MoneShadow/stm32-industrial-protocol-gateway/f103_node/Core/Src/main.c

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
/* Includes ------------------------------------------------------------------*/
#include "main.h"
#include "can.h"
#include "usart.h"
#include "gpio.h"

/* USER CODE BEGIN Includes */

#include "can.h"

/* USER CODE END Includes */


/* USER CODE BEGIN PV */

volatile uint8_t heartbeat_in_flight = 0;
volatile uint8_t stateframe_in_flight = 0;
state volatile state_frame = {0};

/* USER CODE END PV */

void SystemClock_Config(void);
/* USER CODE BEGIN 0 */

volatile static uint16_t least_rpm = 0;
uint8_t Set_RPM(uint16_t rpm) {
  if (rpm == least_rpm) {
    return 2; // 目标转速重复，可以认为设置成功
  }
  if (0) {
    return 0; // 设置失败
  }
  least_rpm = rpm;
  HAL_GPIO_TogglePin(LED_TEST_GPIO_Port, LED_TEST_Pin);
  return 1; // 设置成功
}

uint8_t state_num = 0;
uint8_t Get_State(void) {
  if (0) {
    return 1; // 获取状态失败 以后再实现
  }
  state_frame.curentrpm = 930;
  state_frame.targetrpm = least_rpm;
  state_frame.voltage = 240;
  state_frame.temperature = 36;
  state_frame.state = 0x01;
  state_frame.errorcode = 0x00;
  state_frame.statenum = state_num++;
  return 0; // 获取状态成功
}

/* USER CODE END 0 */

/**
  * @brief  The application entry point.
  * @retval int
  */
int main(void)
{

  /* MCU Configuration--------------------------------------------------------*/

  /* Reset of all peripherals, Initializes the Flash interface and the Systick. */
  HAL_Init();

  /* Configure the system clock */
  SystemClock_Config();

  /* Initialize all configured peripherals */
  MX_GPIO_Init();
  MX_CAN_Init();
  MX_USART1_UART_Init();
  /* Infinite loop */
  /* USER CODE BEGIN WHILE */

  volatile static uint32_t least_tick_heart = 0;
  volatile static uint32_t least_tick_command = 0;
  volatile static uint32_t least_tick_state = 0;
  volatile static uint32_t heart_num = 0;
  least_tick_heart =  HAL_GetTick();
  least_tick_command =  HAL_GetTick();
  least_tick_state =  HAL_GetTick();
  while (1)
  {
    if (((HAL_GetTick() - least_tick_heart) >= 500) && !heartbeat_in_flight) {
      least_tick_heart = HAL_GetTick();
      CAN_Heart(heart_num++);
    }

    /* 执行控制命令 */
    if (((HAL_GetTick() - least_tick_command) >= 10) && Event_Flats.Total_Event > 0) {
      least_tick_command = HAL_GetTick();
      uint8_t commandcode = 0, commanddata[8], commandnum = 0;
      if (Event_Flats.RPM_Event > 0) {
        Event_Flats.Total_Event--;
        Event_Flats.RPM_Event--;
        if (ReadCommandValue(0x01, commanddata)) {
          /* 命令空  */
          Event_Flats.Error_Event++;
        }
        else {
          uint16_t rpm = 0;
          uint8_t status = 0;
          commandcode = commanddata[0];
          rpm = commanddata[1] | commanddata[2] << 8; // 小端序保存
          commandnum = commanddata[3];
          status = Set_RPM(rpm);
          if (status) {
            /* 发送应答 */
            CAN_ACK(commandcode, 0x00, commandnum);
          }
          else {
            CAN_ACK(commandcode, 0x01, commandnum);
            Event_Flats.Error_Event++;
          }
        }
      }
    }

    if (((HAL_GetTick() - least_tick_state) >= 5000) && !stateframe_in_flight) {
      least_tick_state = HAL_GetTick();
      Get_State();
      CAN_State(state_frame);
    }

    if (heartbeat_in_flight == 1 && !HAL_CAN_IsTxMessagePending(&hcan, CAN_Heartbeat_Frame.mailbox)) {
      heartbeat_in_flight = 0;
    }

    if (stateframe_in_flight == 1 && !HAL_CAN_IsTxMessagePending(&hcan, CAN_State_Frame.mailbox)) {
      stateframe_in_flight = 0;
    }
    
    /* USER CODE END WHILE */

    /* USER CODE BEGIN 3 */
  }
  /* USER CODE END 3 */
}

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
