MoneShadow/stm32-industrial-protocol-gateway/stm32-industrial-protocol-gateway.ioc

Mcu.UserName=STM32F407VGTx
PA10.Signal=USART1_RX
PA13.Signal=SYS_JTMS-SWDIO
PA14.Signal=SYS_JTCK-SWCLK
PA9.Signal=USART1_TX
PB2.GPIO_Label=LED_TEST
PB2.Signal=GPIO_Output
PD0.Signal=CAN1_RX
PD1.Signal=CAN1_TX
PD4.GPIO_Label=RS485_DE
PD4.Signal=GPIO_Output
PD5.Signal=USART2_TX
PD6.Signal=USART2_RX
PH0-OSC_IN.Signal=RCC_OSC_IN
PH1-OSC_OUT.Signal=RCC_OSC_OUT
