MoneShadow/stm32-industrial-protocol-gateway/Core/Inc/main.h

#define LED_TEST_Pin GPIO_PIN_2
#define LED_TEST_GPIO_Port GPIOB
#define RS485_DE_Pin GPIO_PIN_4
#define RS485_DE_GPIO_Port GPIOD
