MoneShadow/stm32-industrial-protocol-gateway/Core/Inc/can.h

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
/* Define to prevent recursive inclusion -------------------------------------*/
#ifndef __CAN_H__
#define __CAN_H__

#ifdef __cplusplus
extern "C" {
#endif

/* Includes ------------------------------------------------------------------*/
#include "main.h"

extern CAN_HandleTypeDef hcan1;

/* USER CODE BEGIN Private defines */

typedef struct {
  uint16_t id;
  uint8_t  dlc;
  uint8_t  data[8];
} CAN_Frame;

/* 发送命令帧格式 */
typedef struct {
  CAN_TxHeaderTypeDef CAN_TxHeader;
  uint8_t TxHeader_flat;
  uint32_t mailbox;
  uint8_t data[8];
} CAN_Frame_Tx;

/* 接收命令帧格式 */
typedef struct {
  CAN_RxHeaderTypeDef CAN_RxHeader;
  uint8_t RxHeader_flat;
  uint8_t data[8];
} CAN_Frame_Rx;

extern volatile uint32_t HeartTime;
extern volatile uint32_t can_ack_queue_full_count;

/* USER CODE END Private defines */

void MX_CAN1_Init(void);

/* USER CODE BEGIN Prototypes */

void CAN1_FilterBank_Init(void);
void CAN1_RxDATA_FIFO0(void);
void CAN1_RxDATA_FIFO1(void);
void CAN1_TxDATA(uint8_t *TxDATA, uint8_t len);
void CAN1_Ctrl(uint8_t command_code, uint16_t rpm, uint32_t command_num);
CAN_Frame_Tx register_rpm_command(uint16_t rpm, uint32_t command_num);

/* USER CODE END Prototypes */

#ifdef __cplusplus
}
#endif

#endif /* __CAN_H__ */
