MoneShadow/stm32-industrial-protocol-gateway/(commit log)

2026-09-01 初始化工程项目
2026-09-01 手动导入FreeRTOS(堆内存管理方案为4)
2026-09-01 给FreeRTOS添加链接关系
2026-09-01 安装FreeRTOS中断服务程序替换掉裸机程序中的三个中断
2026-09-01 添加C语言服务器配置
2026-09-01 创建第一个FreeRTOS任务，测试项目配置是否创建无误
2026-09-01 修改cubemx生成代码格式(我说怎么什么初始化都往main里面塞)
2026-09-01 该开发板的外部高速时钟是8Mhz
2026-09-05 使用cubemx初始化CAN1并开启RX_FIFO0中断 使用cubemx初始化UART1并开启中断
2026-09-05 修改CAN1为内回环模式
2026-09-05 实现 CAN 回环帧队列传递与串口转发
2026-09-05 新增 F103 CAN 模拟下位机工程
2026-09-05 修正.gitignore文件 修复误设置的f103晶振配置
2026-09-05 实现 F103 与 F407 正常模式 CAN 通信
2026-09-05 实现 CAN 控制命令与 ACK 业务闭环
2026-09-06 修复：避免 F103 心跳堆积占满 CAN 发送邮箱
    [can.c, can.h, main.c, main.h]
2026-09-06 修复：ACK 发送失败时不再让 F103 停机
    [can.c]
2026-09-06 重构：完善 F407 CAN 收发与在线状态管理
2026-09-06 调整：完善 F103 CAN 收发异常处理配置
2026-09-08 调整：调整上线恢复状态逻辑
2026-09-08 重构：重构从机端的can帧发送逻辑
2026-09-08 新增：实现 CAN 状态帧收发并临时处理串口并发
2026-09-09 调整：修改FreeRTOS的堆大小为 16K 开启内存分配失败检测 开始栈溢出检测
2026-09-09 修复：修复上次对于FreeRTOS的错误配置
2026-09-10 完善：实现 F407 设备模型并增强状态与内存异常诊断
2026-09-10 实现：完成 RS485 半双工 DMA 空闲接收与数据回传
2026-09-12 实现：完成 Modbus RTU 0x03 寄存器读取与异常响应
2026-09-14 实现：添加 Modbus 0x06 请求解析与写入参数校验同时重构两处检查及初步解析函数
2026-09-14 实现：实现 Modbus 目标转速写入与 CAN 控制闭环
2026-09-14 完胜：完善控制命令 ACK 匹配与执行确认超时处理
2026-09-14 完善：完善 CAN 忙碌等待与离线待发送命令清理
2026-09-14 修复：修复 CAN 超时挂起帧取消及发送错误后的状态恢复
2026-09-14 优化：使用互斥锁保护 USART1 日志并移除打印期间的调度暂停
2026-09-14 优化：保护 CAN 状态更新并使用设备模型快照输出日志
2026-09-14 修复：修复 CAN 发送标志置位与完成回调的时序竞态
2026-09-14 修复：修正节点上线心跳计数与超时后的累计重置
2026-09-14 修复：修正网关启动时的节点默认在线状态
2026-09-14 完善：完善节点上线确认与连续心跳超时判定
2026-09-14 优化：优化 CAN 状态队列并统计高负载下的丢失帧
2026-09-14 新增：增加 CAN ACK 队列溢出统计
2026-09-14 新增：增加 FreeRTOS 任务栈余量监控
2026-09-14 完善：完善两端 CAN 业务帧格式校验
2026-09-14 文档：完善工业协议网关初版 README
2026-09-14 文档：补充项目实物照片与功能演示
